kaduhi/sf-hab_rp2040_picoballoon_tracker_pcb_gen1/pcb/tracker/v0.4/SCH_Schematic1_2023-09-11.pdf

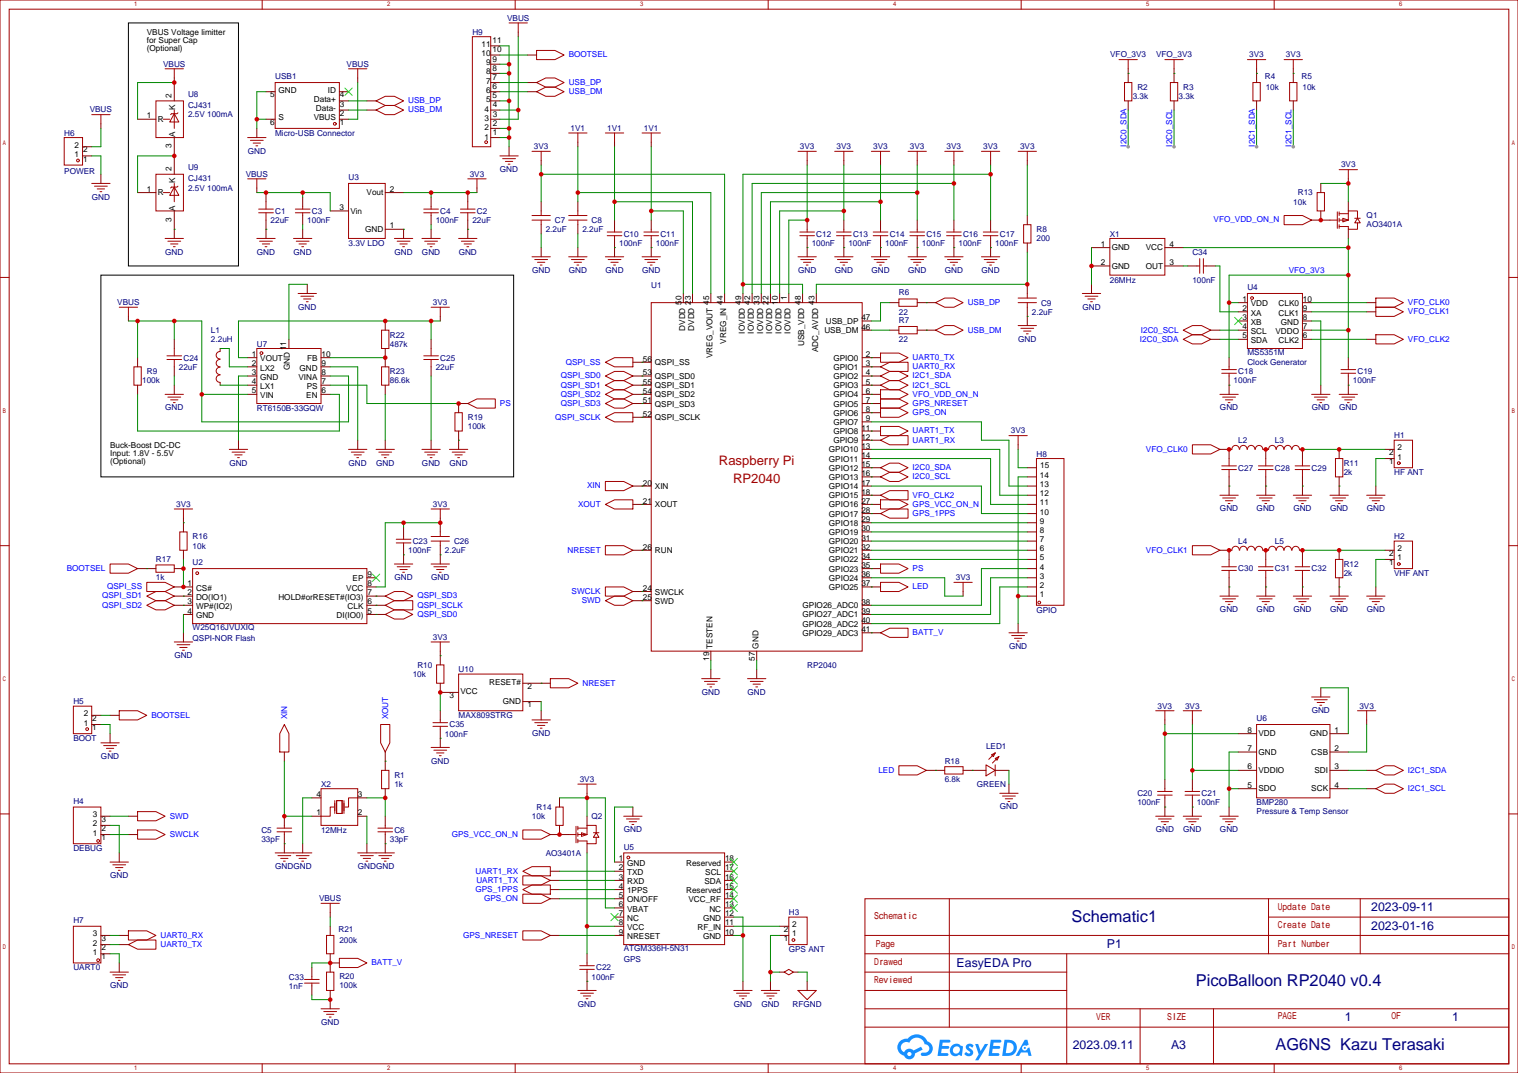
[picture p11: page 1]

Buck-Boost DC-DC
Input: 1.8V - 5.5V
(Optional)
