kaduhi/sf-hab_rp2040_picoballoon_tracker_pcb_gen1/pcb/tracker/v0.1/SCH_Schematic1_2023-02-14.pdf

# 26MHz I2C⁰_SDA

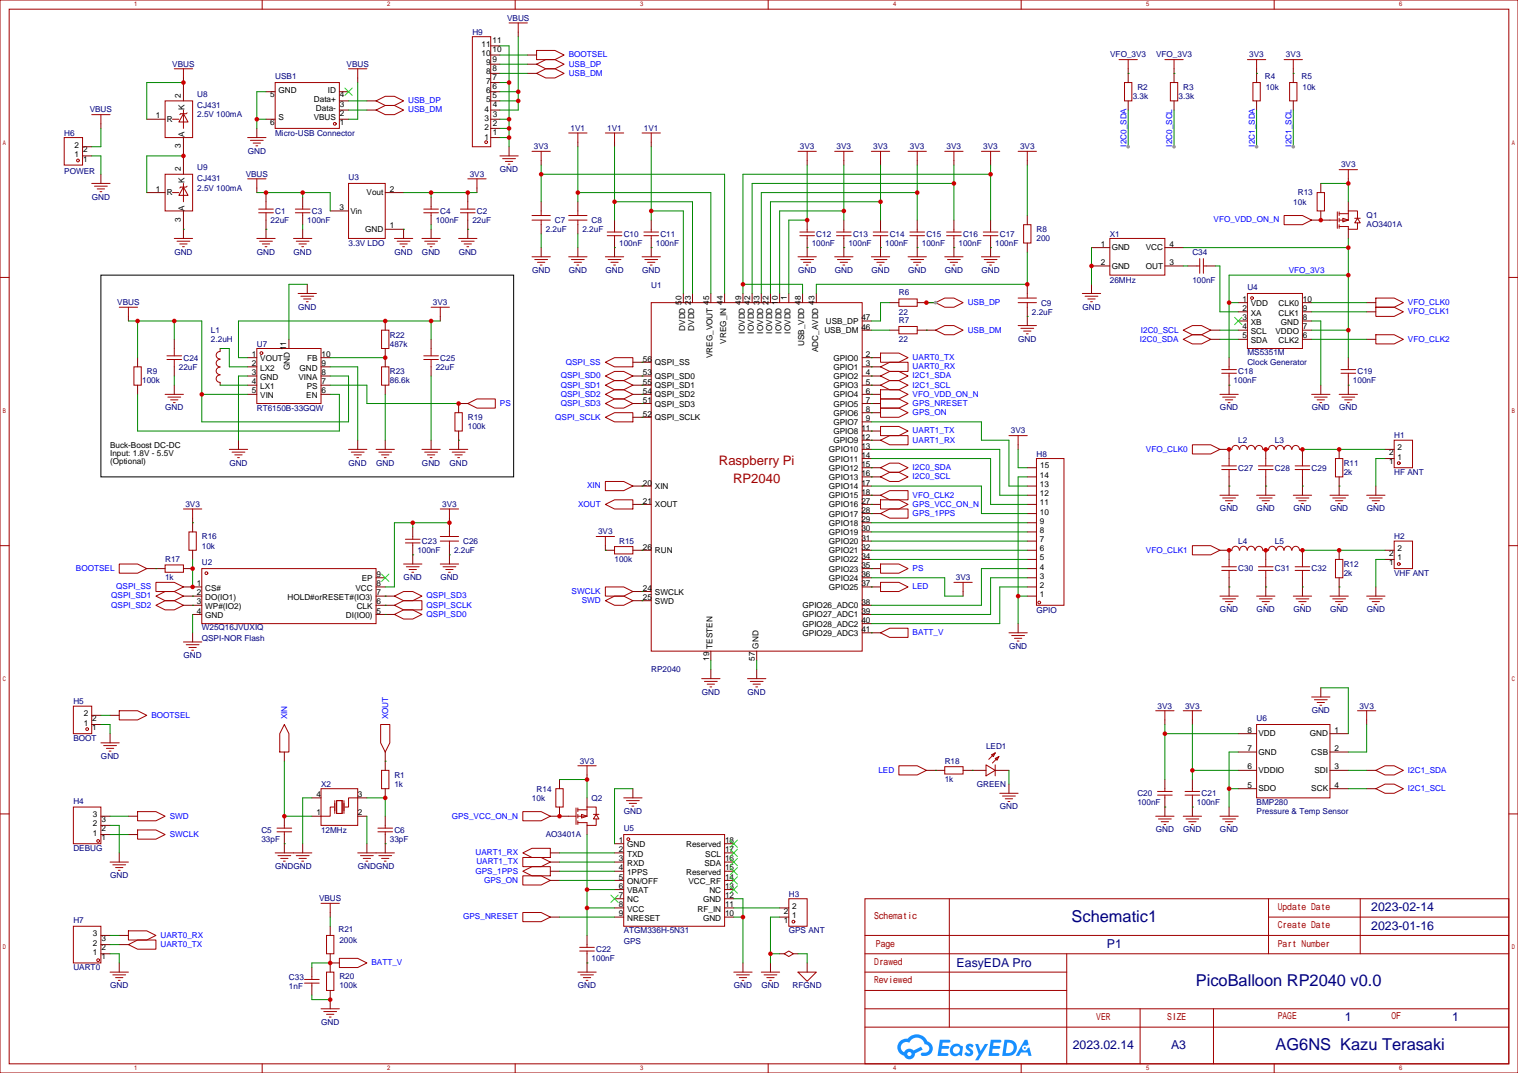
[picture p12: page 1]

Buck-Boost DC-DC
Input: 1.8V - 5.5V
(Optional)
