kaduhi/sf-hab_rp2040_picoballoon_tracker_pcb_gen1/pcb/tracker/v0.2/SCH_Schematic1_2023-03-23_v0.2.pdf

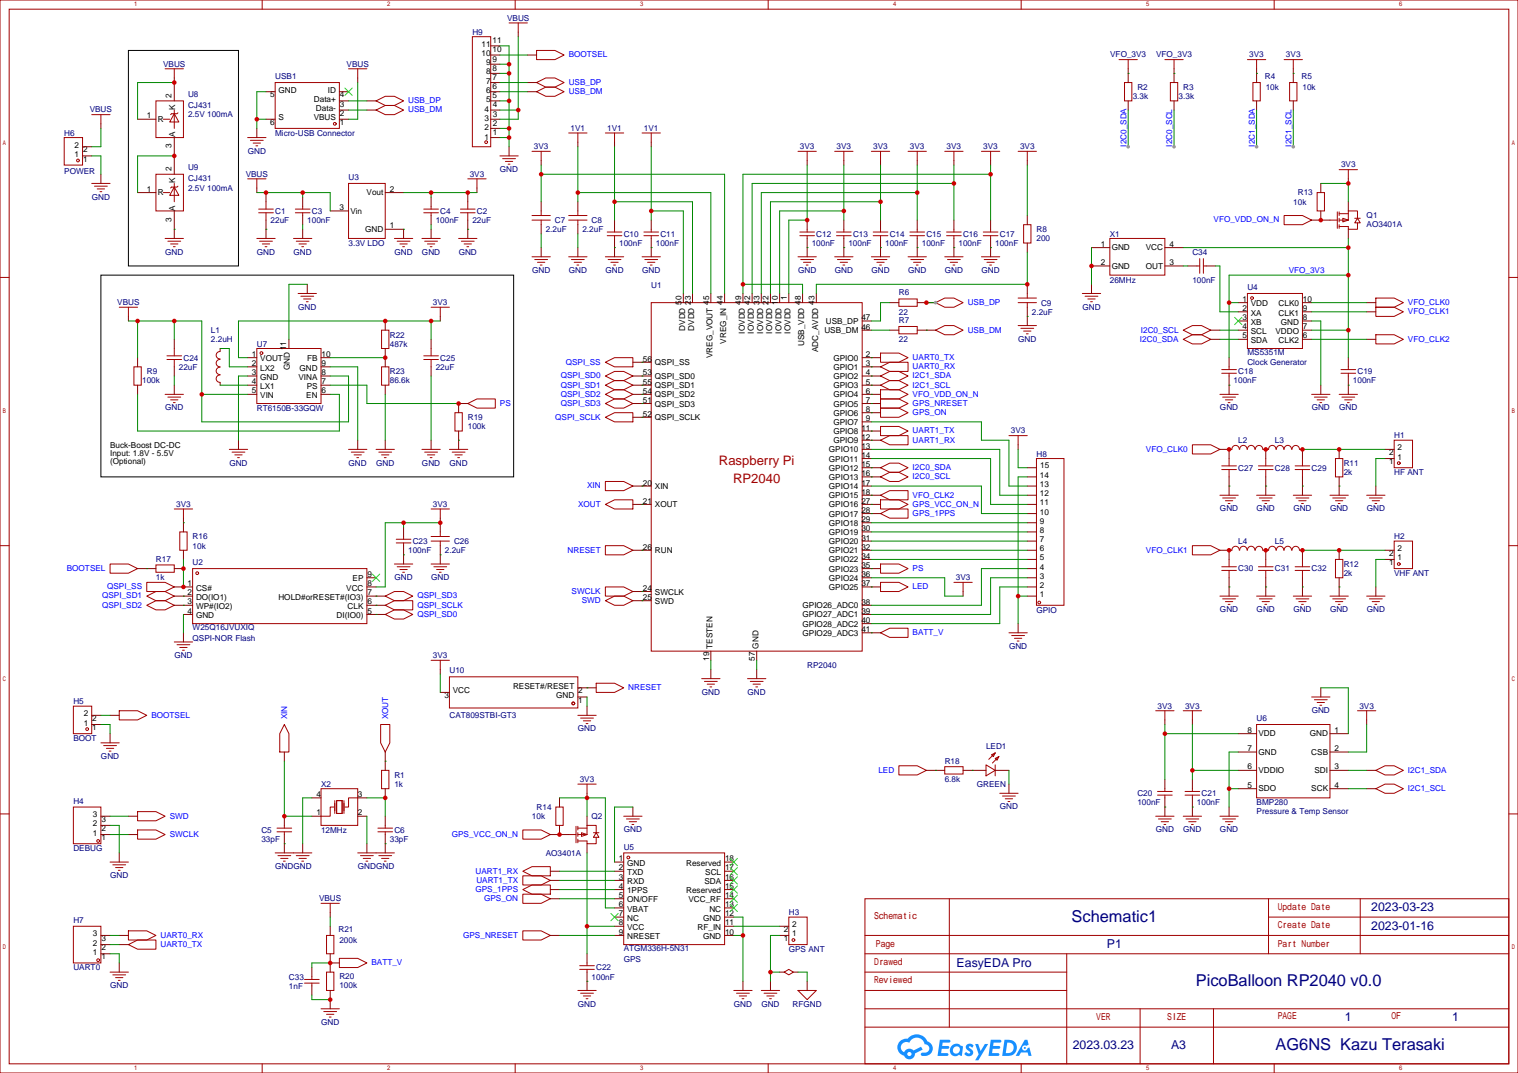
[picture p13: page 1]

Buck-Boost DC-DC
Input: 1.8V - 5.5V
(Optional)
