kaduhi/sf-hab_rp2040_picoballoon_tracker_pcb_gen1/pcb/tracker/v0.3.1/SCH_Schematic1_2023-07-09.pdf

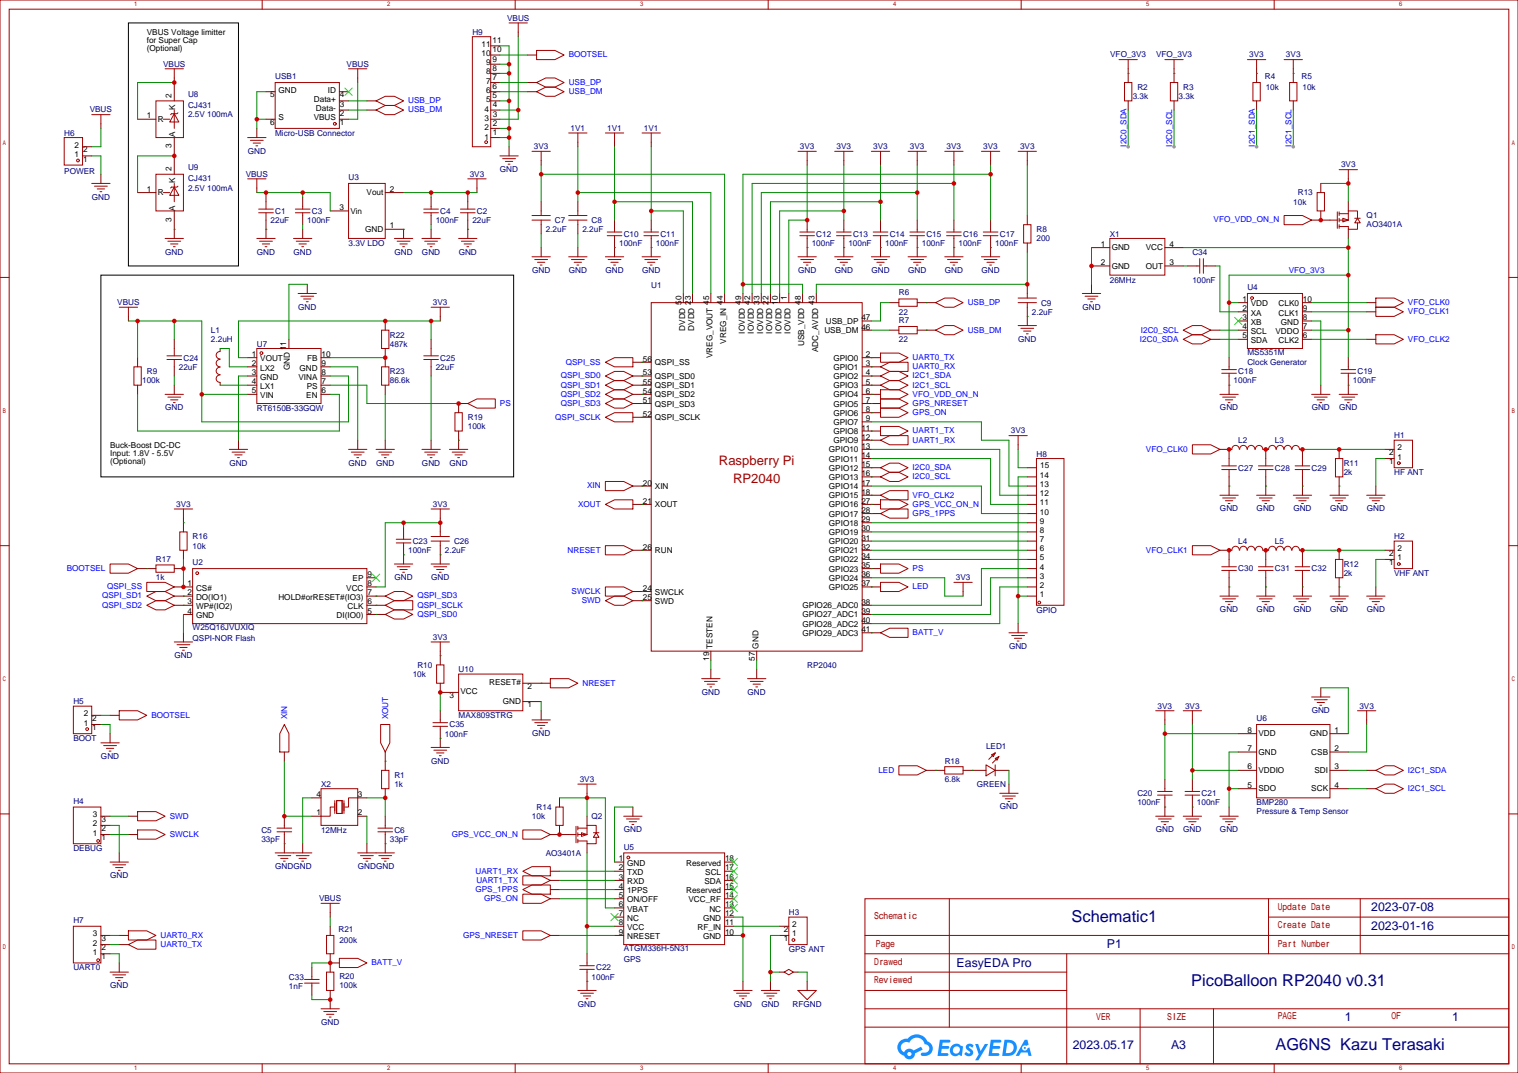
[picture p14: page 1]

Buck-Boost DC-DC
Input: 1.8V - 5.5V
(Optional)
