kaduhi/sf-hab_rp2040_picoballoon_tracker_pcb_gen1/pcb/tracker/v0.3/SCH_Schematic1_2023-05-23.pdf

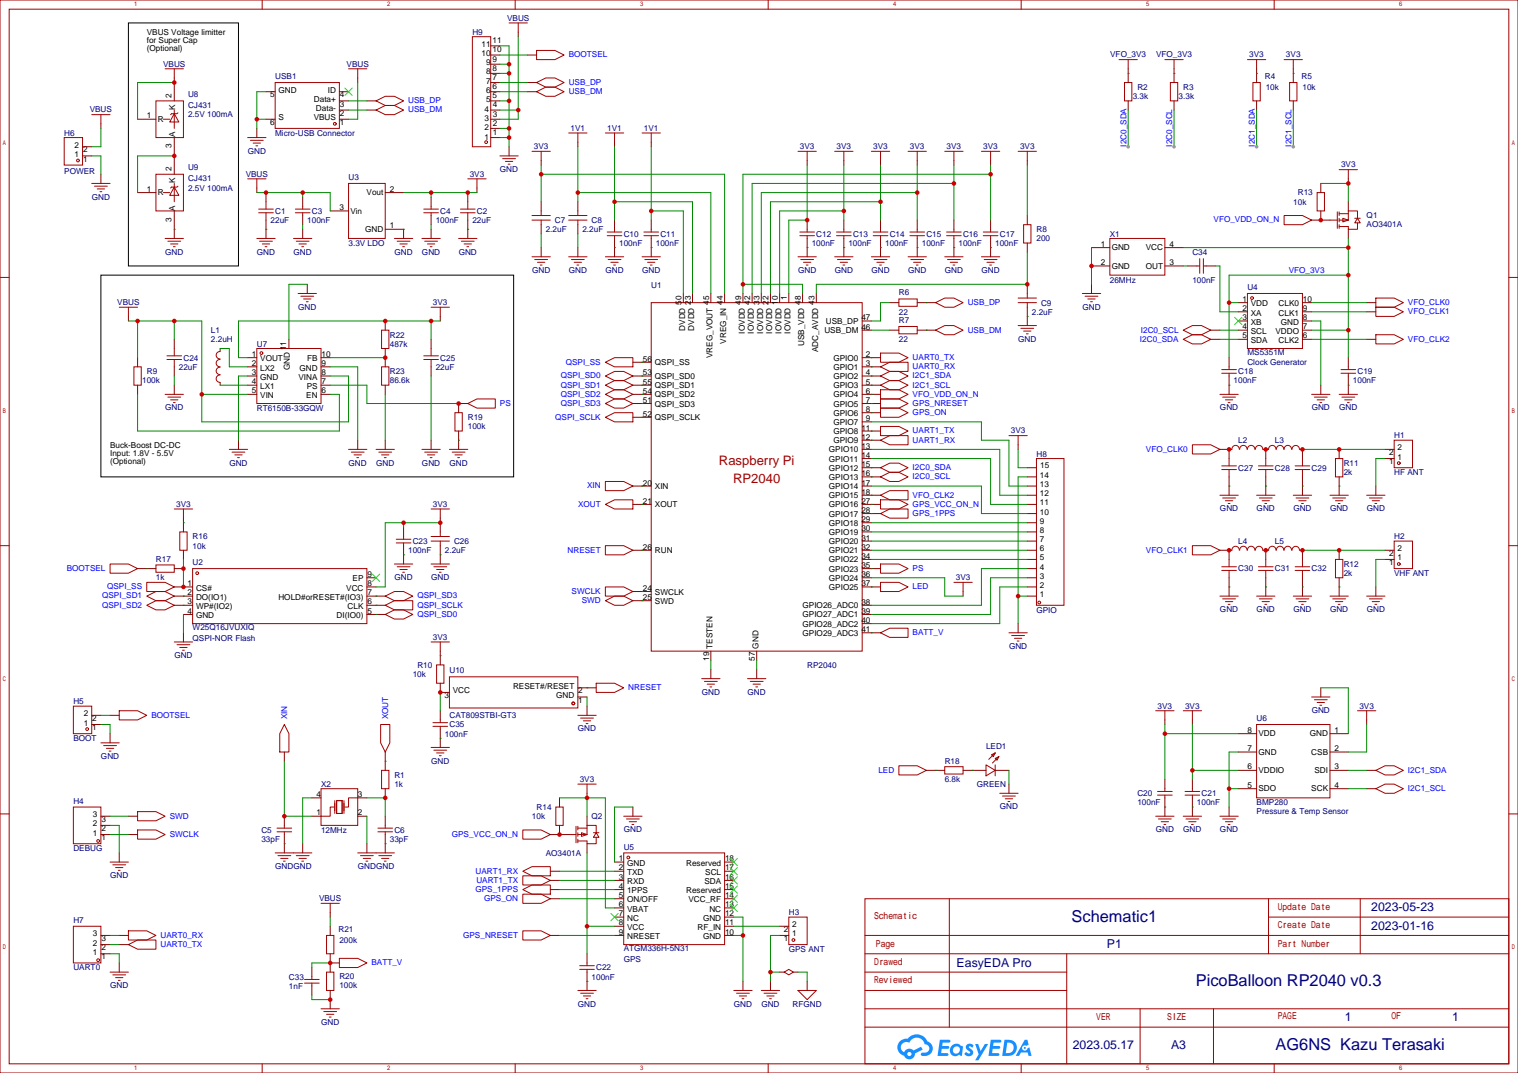
[picture p15: page 1]

Buck-Boost DC-DC
Input: 1.8V - 5.5V
(Optional)
