kaduhi/sf-hab_rp2040_picoballoon_tracker_pcb_gen1/(list of files, drawings)

Other design files:
pcb/boost_converter/boost_0.8V_to_3.3V_v0.1.eprj
pcb/tracker/v0.2/AG6NS_PicoBalloon_RP2040_v0.2.eprj
pcb/tracker/v0.3.1/AG6NS_PicoBalloon_RP2040_v0.31.eprj
pcb/tracker/v0.3/AG6NS_PicoBalloon_RP2040_v0.3.eprj
pcb/tracker/v0.4/AG6NS_PicoBalloon_RP2040_v0.4.eprj
